itadinanta/cnc_mill_prototype/atx_board.FCStd

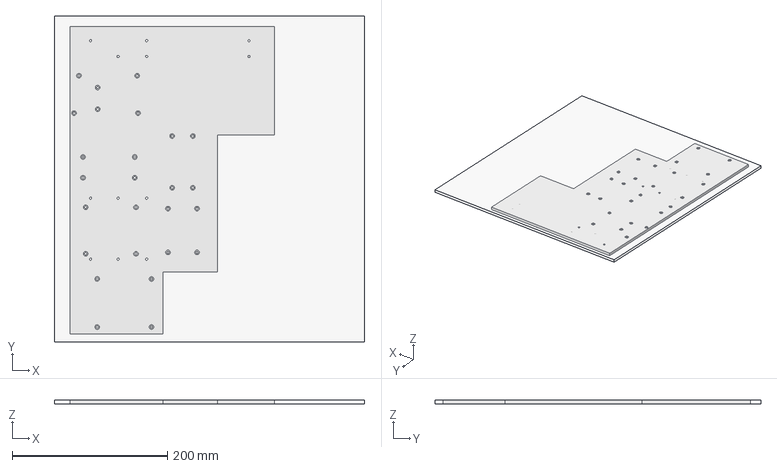
[picture p1: CAD file, 2020-03-13]
atx_board.FCStd
400.0 x 420.0 x 5.00 mm
Back_Face
Stock001
