itadinanta/cnc_mill_prototype/bed/bed.FCStd

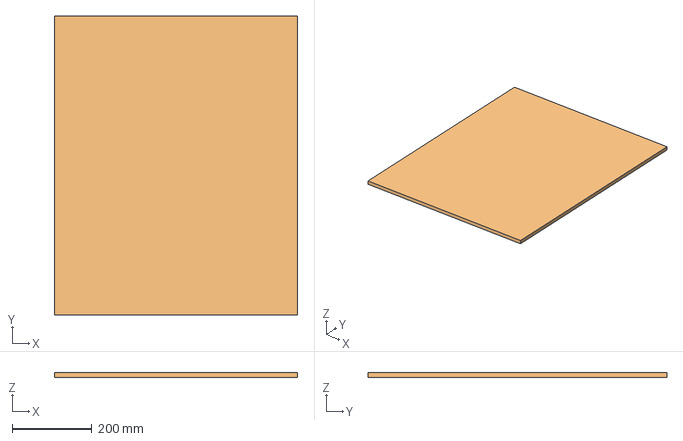
[picture p2: CAD file, 2020-03-01]
bed/bed.FCStd
610.0 x 750.0 x 12.0 mm
Stock
Stock001
