itadinanta/cnc_mill_prototype/test/calibration.FCStd

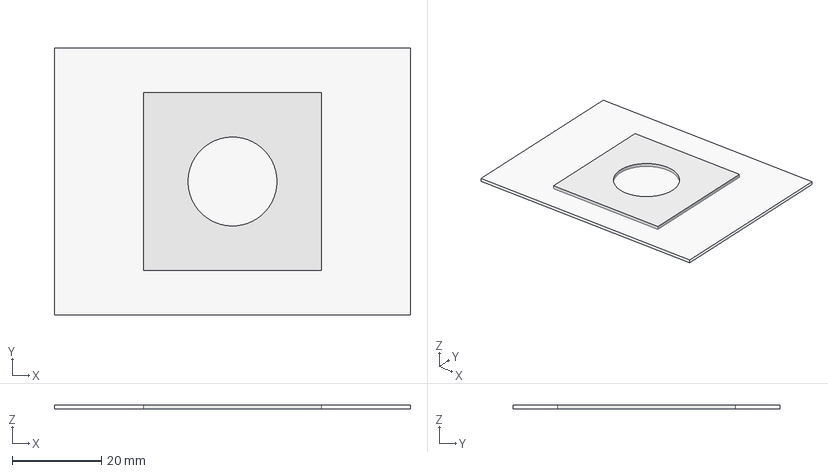
[picture p3: CAD file, 2019-11-09]
test/calibration.FCStd
80.0 x 60.0 x 1.00 mm
Model-Part
Stock
