itadinanta/cnc_mill_prototype/workbench/workbench.FCStd

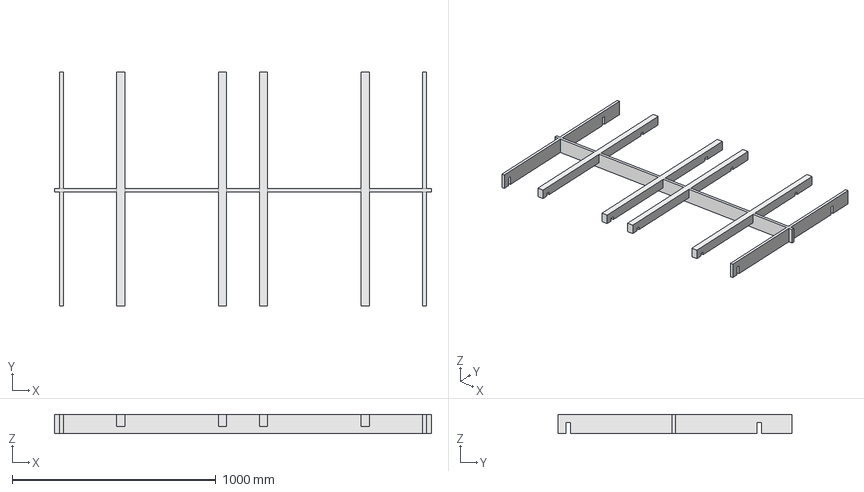
[picture p4: CAD file, 2019-11-04]
workbench/workbench.FCStd
1850.0 x 1150.0 x 95.0 mm
