itadinanta/cnc_mill_prototype/touch_plate.FCStd

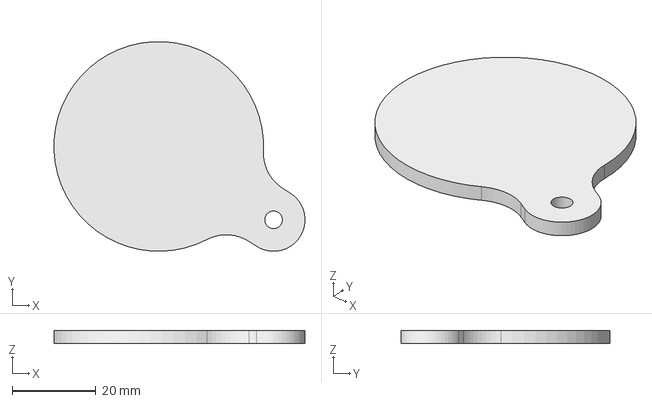
[picture p5: CAD file, 2020-02-16]
touch_plate.FCStd
59.9 x 50.0 x 3.00 mm
