itadinanta/cnc_mill_prototype/workbench/box.FCStd

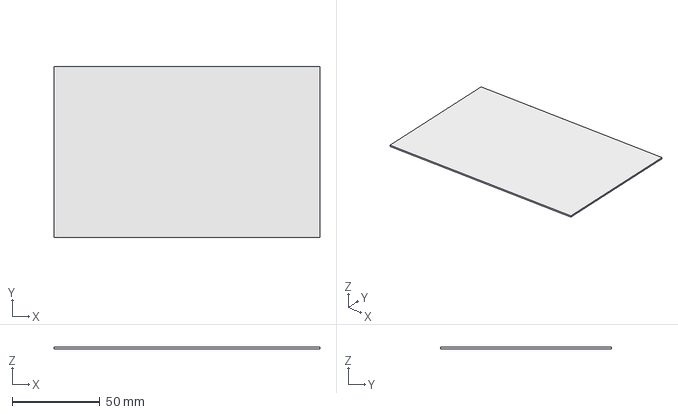
[picture p6: CAD file, 2019-11-03]
workbench/box.FCStd
152.0 x 98.0 x 1.00 mm
