itadinanta/cnc_mill_prototype/inverter_holder.FCStd

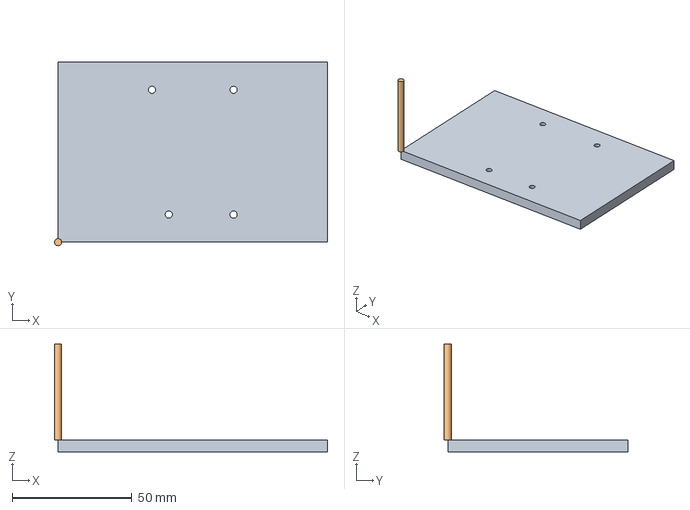
[picture p7: CAD file, 2019-12-30]
inverter_holder.FCStd
113.8 x 76.5 x 45.0 mm
tool
