itadinanta/cnc_mill_prototype/spindle_bracket_adapter.FCStd

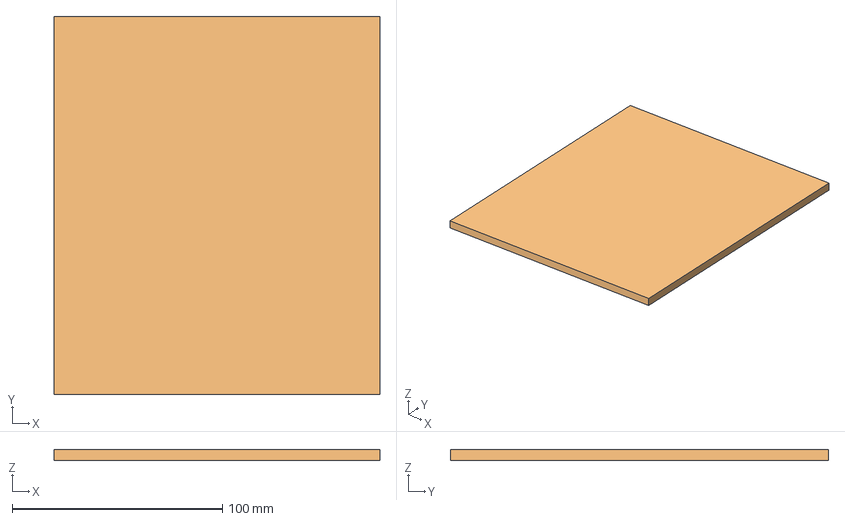
[picture p8: CAD file, 2019-12-23]
spindle_bracket_adapter.FCStd
155.0 x 180.0 x 5.00 mm
Stock
Stock001
