itadinanta/cnc_mill_prototype/cnc_mill_prototype.FCStd

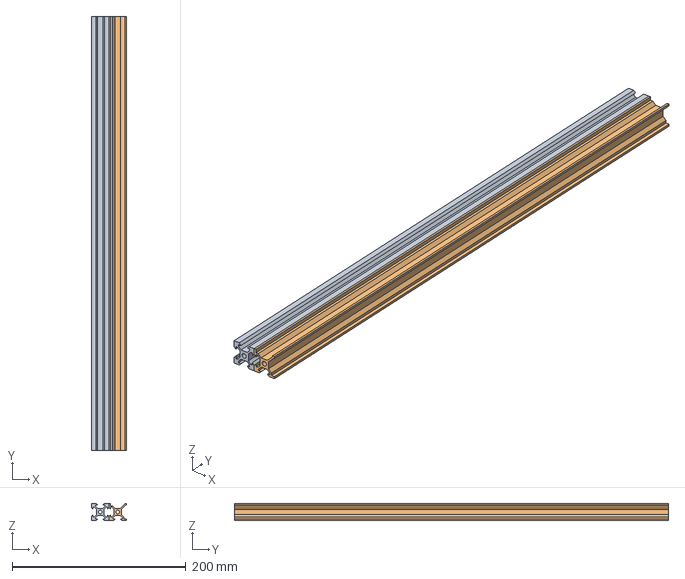
[picture p9: CAD file, 2019-07-23]
cnc_mill_prototype.FCStd
40.0 x 500.0 x 20.0 mm
