itadinanta/cnc_mill_prototype/(list of files, drawings)

Other design files:
arduino_duo_shield/arduino_duo_shield.dsn
