itadinanta/cnc_mill_prototype/arduino_duo_shield/arduino_duo_shield.kicad_pcb

## KiCad design arduino_duo_shield/arduino_duo_shield.kicad_pcb (2020-02-06)

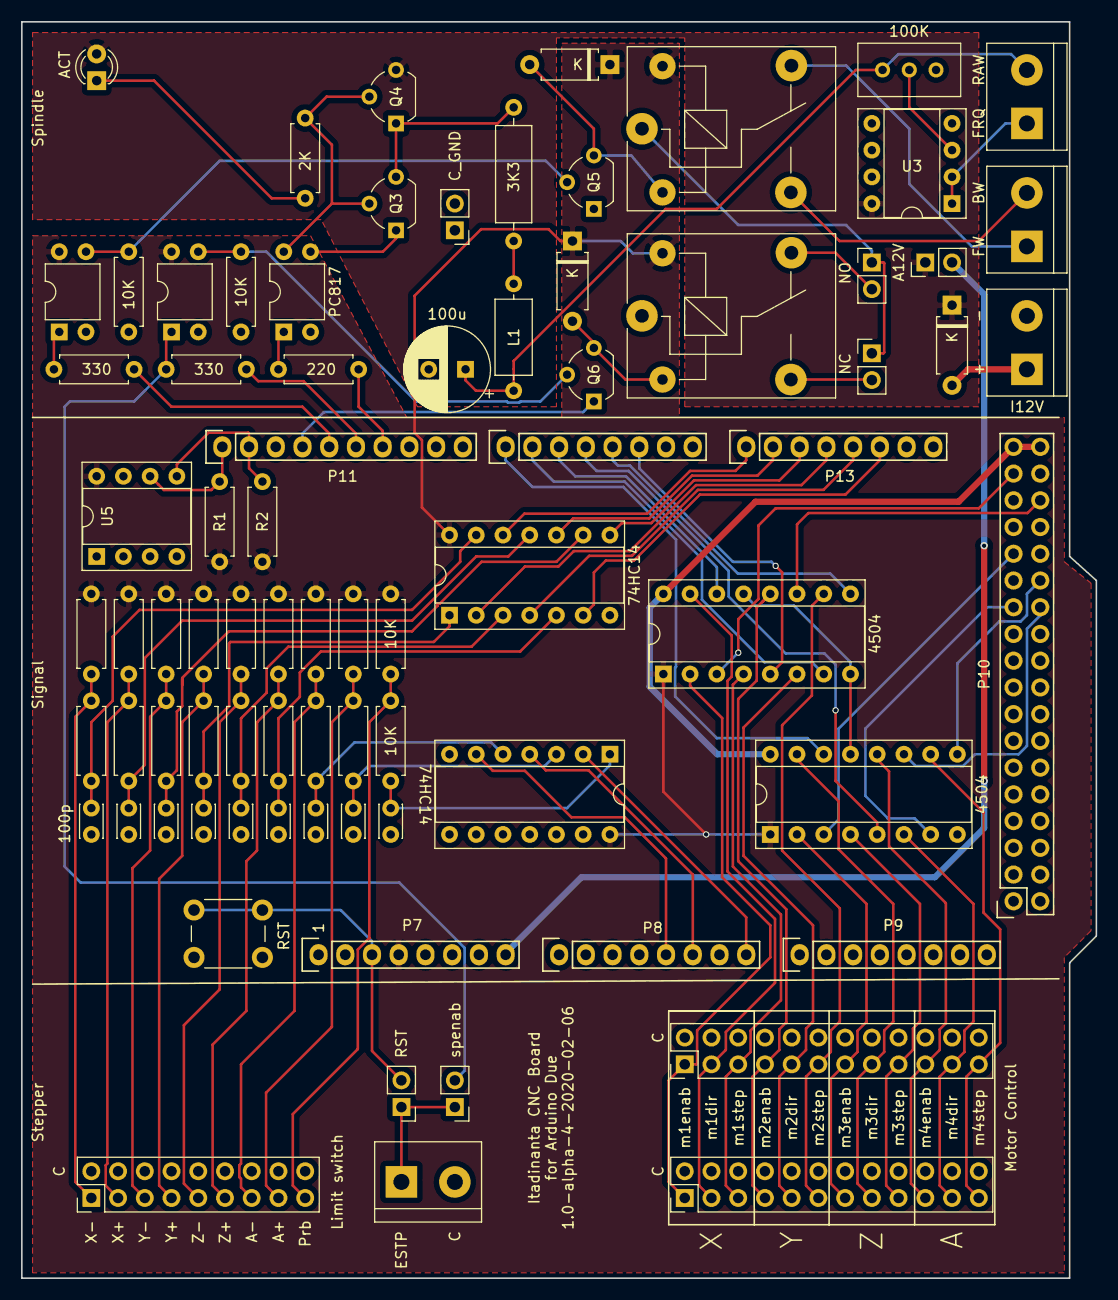
[picture p10: board arduino_duo_shield.kicad_pcb from above]

Board: 2 copper layers, 102.1 x 119.4 mm, 79 parts (0 on the bottom side), 84 nets.

Parts:
C2, C3, C4, C5, C6, C7, C9, C10, C11: 100p; C_Disc_D3.0mm_W2.0mm_P2.50mm
C8: 100u; CP_Radial_D8.0mm_P3.50mm
D1: LED; LED_D3.0mm
D3, D4, D5: 1N4007; D_A-405_P7.62mm_Horizontal
J2: EStop; TerminalBlock_bornier-2_P5.08mm
J3: Motor_Control; PinHeader_2x12_P2.54mm_Vertical
J4: Limit_Switches; PinHeader_2x09_P2.54mm_Vertical
J5: inverter_freq; TerminalBlock_bornier-2_P5.08mm
J6: inverter_cmd; TerminalBlock_bornier-2_P5.08mm
J8: inverter_power; TerminalBlock_bornier-2_P5.08mm
J9: Motor_Control_Mirror; PinHeader_2x12_P2.54mm_Vertical
JP1, JP2, JP3, JP4: Jumper_NC_Small; PinHeader_1x02_P2.54mm_Vertical
JP5: EStop_RST; PinHeader_1x02_P2.54mm_Vertical
JP6: EStop_spenab; PinHeader_1x02_P2.54mm_Vertical
K2, K3: JQC-3F; Relay_SPDT_SANYOU_SRD_Series_Form_C
L1: 1m; L_Axial_L7.0mm_D3.3mm_P10.16mm_Horizontal_Fastron_MICC
P7: Power; Socket_Strip_Arduino_1x08
P8, P9: Analog; Socket_Strip_Arduino_1x08
P10: Digital; Socket_Strip_Arduino_2x18
P11: PWM; Socket_Strip_Arduino_1x10
P12: PWM; Socket_Strip_Arduino_1x08
P13: Communication; Socket_Strip_Arduino_1x08
Q3, Q5, Q6: 2N7000; TO-92_Wide
Q4: BS250; TO-92_Wide
R1, R2: 1K5; R_Axial_DIN0207_L6.3mm_D2.5mm_P7.62mm_Horizontal
R3, R4, R5, R6, R7, R8, R9, R10, R11, R12, R13, R14, R19, R20, R25, R26, R27, R28, R29, R30: 10K; R_Axial_DIN0207_L6.3mm_D2.5mm_P7.62mm_Horizontal
R15: 220; R_Axial_DIN0207_L6.3mm_D2.5mm_P7.62mm_Horizontal
R21: 2K; R_Axial_DIN0207_L6.3mm_D2.5mm_P7.62mm_Horizontal
R22, R24: 330; R_Axial_DIN0207_L6.3mm_D2.5mm_P7.62mm_Horizontal
R23: 3K3; R_Axial_DIN0309_L9.0mm_D3.2mm_P12.70mm_Horizontal
RV1: 100K; Potentiometer_Bourns_3296W_Vertical
SW1: SW_Push; SW_PUSH_6mm
U1, U2: 4504; DIP-16_W7.62mm_Socket
U3: LM358; DIP-8_W7.62mm_Socket
U4, U6: 74HC14; DIP-14_W7.62mm_Socket
U5: 24LC16; DIP-8_W7.62mm_Socket
U7, U8, U9: PC817; DIP-4_W7.62mm

Connections:
+3V3: D3.1, D4.1, K2.5, K3.5, P7.4, R1.2, R2.1, R3.2, R5.2, R7.2, R9.2, R11.2, R13.2, R19.2, R27.2, R29.2, U1.1, U2.1, U4.14, U5.8, U6.14, U8.4, U9.4
+5V: P10.35, P10.36, U1.16, U2.16
/Debounce_x6/SWAmax+: J4.15, R27.1, R28.2
/Debounce_x6/SWAmin+: J4.13, R29.1, R30.2
/Debounce_x6/SWProbe+: J4.17, R19.1, R20.2
/Debounce_x6/SWXmax+: J4.3, R11.1, R12.2
/Debounce_x6/SWXmin+: J4.1, R13.1, R14.2
/Debounce_x6/SWYmax+: J4.7, R7.1, R8.2
/Debounce_x6/SWYmin+: J4.5, R9.1, R10.2
/Debounce_x6/SWZmax+: J4.11, R3.1, R4.2
/Debounce_x6/SWZmin+: J4.9, R5.1, R6.2
/Level_Shifter/hi_1_1: J3.1, J9.1, U1.2
/Level_Shifter/hi_1_2: J3.3, J9.3, U1.15
/Level_Shifter/hi_1_3: J3.5, J9.5, U1.4
/Level_Shifter/hi_1_4: J3.7, J9.7, U1.12
/Level_Shifter/hi_1_5: J3.9, J9.9, U1.6
/Level_Shifter/hi_1_6: J3.11, J9.11, U1.10
/Level_Shifter/hi_2_1: J3.13, J9.13, U2.2
/Level_Shifter/hi_2_2: J3.15, J9.15, U2.15
/Level_Shifter/hi_2_3: J3.17, J9.17, U2.4
/Level_Shifter/hi_2_4: J3.19, J9.19, U2.12
/Level_Shifter/hi_2_5: J3.21, J9.21, U2.6
/Level_Shifter/hi_2_6: J3.23, J9.23, U2.10
/Reset: JP5.2, P7.3, SW1.2
/SCL: P11.1, R1.1, U5.6
/SDA: P11.2, R2.2, U5.5
/Spindle_VFD_Control/I_PWRSAFE: D1.2, D5.1, JP4.1, Q4.3, U3.8
/Spindle_VFD_Control/ext_estop: JP6.2, R24.2, U9.1
/Spindle_VFD_Control/inverter_12V: D5.2, J8.1
/Spindle_VFD_Control/inverter_bw_switch: J6.2, K3.3
/Spindle_VFD_Control/inverter_frequency_10V: J5.1, U3.1, U3.2
/Spindle_VFD_Control/inverter_frequency_raw_10V: C8.1, J5.2, L1.2, RV1.1
/Spindle_VFD_Control/inverter_fw_switch: J6.1, K3.4
/Spindle_VFD_Control/inverter_gnd: C8.2, J8.2, JP1.1, K2.1, Q3.1, RV1.3, U3.4, U7.3
Amn: P8.5, U6.6
Amx: P8.6, U6.4
GND: C2.1, C3.1, C4.1, C5.1, C6.1, C7.1, C9.1, C10.1, C11.1, J2.2, J3.2, J3.4, J3.6, J3.8, J3.10, J3.12, J3.14, J3.16, J3.18, J3.20, J3.22, J3.24, J4.2, J4.4, J4.6, J4.8, J4.10, J4.12, J4.14, J4.16, J4.18, J9.2, J9.4, J9.6, J9.8, J9.10, J9.12, J9.14, J9.16, J9.18, J9.20, J9.22, J9.24, JP1.2, P7.6, P7.7, P10.1, P10.2, P11.4, Q5.1, Q6.1, R25.2, R26.2, SW1.1, U1.8, U1.13, U2.8, U2.13, U4.7, U5.4, U5.7, U6.7, U7.2, U8.2, U9.2
unnamed: C2.2, R4.1, U4.5
unnamed: C3.2, R6.1, U4.3
unnamed: C4.2, R8.1, U4.1
unnamed: C5.2, R10.1, U4.9
unnamed: C6.2, R12.1, U4.11
unnamed: C7.2, R14.1, U4.13
unnamed: C9.2, R20.1, U6.1
unnamed: C10.2, R28.1, U6.3
unnamed: C11.2, R30.1, U6.5
unnamed: D1.1, R21.1
unnamed: D3.2, K3.2, Q5.3
unnamed: D4.2, K2.2, Q6.3
unnamed: J2.1, JP5.1, JP6.1
unnamed: JP2.1, JP3.1, K3.1
unnamed: JP2.2, K2.3
unnamed: JP3.2, K2.4
unnamed: L1.1, R23.2
unnamed: Q3.2, Q4.2, R21.2, U7.4
unnamed: Q3.3, Q4.1, R23.1
unnamed: Q5.2, R25.1, U8.3
unnamed: Q6.2, R26.1, U9.3
unnamed: R15.2, U7.1
unnamed: R22.2, U8.1
unnamed: RV1.2, U3.3
Probe: P8.8, U6.2
Xmn: P13.1, U4.12
Xmx: P13.2, U4.10
Ymn: P13.3, U4.8
Ymx: P13.4, U4.2
Zmn: P13.5, U4.4
Zmx: P13.6, U4.6
ext_12v: JP4.2, P7.8
m1dir: P12.3, U1.14
m1enab: P10.33, U1.3
m1step: P12.6, U1.5
m2dir: P12.2, U1.7
m2enab: P10.32, U1.11
m2step: P12.5, U1.9
m3dir: P12.1, U2.14
m3enab: P10.27, U2.3
m3step: P12.4, U2.5
m4dir: P10.23, U2.7
m4enab: P10.24, U2.11
m4step: P10.26, U2.9
spdir: P11.5, R22.1
spenab: P11.6, R24.1
sppwm: P11.7, R15.1
