itadinanta/cnc_mill_prototype/(threads)

Thread 1 (2020-01-24):

Screw connectors

coredump, 2020-01-24:
Hello! I saw your comment on the GRBL HAL discussion and promptly decided to make some of your shields.

I have a question and a request tho:

1) How does the Schmitt trigger compare to the GRBL wiki solution using opto-couplers?
2) I changed the PCB to use screw connectors instead of pin headers, would love if you could take a look at my branch (https://github.com/coredump/cnc_mill_prototype/tree/coredump_screw_connectors) to see if I am not forgetting/doing something stupid before sending it to JLPCB 😄

Thanks, the shield looks awesome and I am excited to use it.

norru, 2020-02-03:
Oh, cool!

1. I haven't tried the optocoupler solution but the Schmitt debouncers work flawlessly for me. I've been recommended to try the optocoupler solution too, will probably give it a shot in the future.

2. Alright, I'll try and see if I can have a peek this week!

> Thanks, the shield looks awesome and I am excited to use it.

Oh, dear, what courage! :D Good luck with that, bear in mind this is a work in progress, but very happy to be of help!

norru, 2020-02-05:
@coredump I've added external EEPROM to my board schematic. It's a simple addition that you may want to sync over.

I'll probably tidy up a little bit then send it out for etching. If you wait a bit I'll get this tested first so you don't have to play blind :)

coredump, 2020-02-06:
That's interesting. How would you use the EEPROM? Does any of the firmwares support it out of the box?

norru, 2020-02-06:
Yes, it's been recommended by @terjejo as I'm using his branch of GRBL https://github.com/terjeio/grblHAL (with small tweaks on top).

coredump, 2020-02-07:
Hello again. I surely hope your stuff is open source, because I got a log of ideas from you to make this 😄

https://cadlab.io/project/2459/1f6db917/files

My plan is to make a 'generic' daughter card that can be used with differnt MCUs/firmwares. So what I basically did was to shove everything I need to run with external drivers/VFDs/opto isolated switches and 3.3v logic on a single board. I kinda copied the connector design from MESA cards too.

I still testing those circuits on a breadboard, and I think  my PWM-10V converter is a little too complicated/maybe unsafe, but I will probably make some of those prototype boards and test it.

I am also creating smaller shields for ESP32, Arduino Due and a connector for TIVA-C boards that I will use to test GRBLHAL and g2core.

I would appreciate any tips/reviews/ideas, and again sorry because there are some stuff on my work that is clearly almost the same as yours (there are only so many ways I can put an eeprom chip) but if it bothers you lmk and I will change it.

norru, 2020-02-08:
Hi José,

sure, all the public stuff I've got on GitHub is open source and it's an
original design.

Perhaps I should make it clear and upload a Creative Commons disclaimer,the
idea is to go for https://creativecommons.org/licenses/by-sa/4.0/ or even
https://creativecommons.org/licenses/by/4.0/.

I have no plans to distribute or sell my boards as finished products, all I
need is a bespoke design which works for me, but I am super happy to share
and compare notes on anything interesting.

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

--
Cheers,
Nico

coredump, 2020-02-08:
As a GPL person, I will probably use this
https://creativecommons.org/share-your-work/licensing-examples/#by-nc-sa or
research some OHW license.

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

norru, 2020-02-08:
I am ok for people to use these projects in a commercial context as long as
I am credited, at least for now.

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
