itadinanta/cnc_mill_prototype/(commit log)

2019-07-20 Added holes as pockets
    [cnc_mill_prototype.FCStd]
2019-07-21 Basic C-Beam profile
    [cnc_mill_prototype.FCStd]
2019-07-21 Adds corner side by side
    [cnc_mill_prototype.FCStd]
2019-07-23 Last V-slot sketch
    [cnc_mill_prototype.FCStd]
2019-08-21 Add debounce x6 for limit switches
    [Debounce_x6.sch, arduino_duo_shield.kicad_pcb, arduino_duo_shield.sch]
2019-08-31 Add labels and footprints
    [Debounce_x6.sch, arduino_duo_shield.kicad_pcb, arduino_duo_shield.sch]
2019-09-01 Replace 4x 6x connectors with 1x 24x, add firmware
    [Debounce_x6.sch, arduino_duo_shield.kicad_pcb, arduino_duo_shield.sch]
2019-09-02 Add firmware to fix the power-on bug
2019-09-06 Fixed power pins
    [arduino_duo_shield.sch]
2019-09-11 Use only 1 VPOW in spindle control
    [Debounce_x6.sch, Spindle_Power_Control.sch, arduino_duo_shield.kicad_pcb, arduino_duo_shield.sch]
2019-09-12 Power block to PCB
    [Spindle_Power_Control.sch, arduino_duo_shield.kicad_pcb, arduino_duo_shield.sch]
2019-09-14 Add PCB front/back for spindle controls
    [Spindle_Power_Control.sch, arduino_duo_shield.kicad_pcb, arduino_duo_shield.sch]
2019-09-21 Complete wiring
    [Debounce_x6.sch, Level_Shifter.sch, Spindle_Power_Control.sch, arduino_duo_shield.kicad_pcb, arduino_duo_shield.sch]
2019-09-22 Plot layouts to upload to to JLBPCB
    [arduino_duo_shield-B_CrtYd.gbr, arduino_duo_shield-B_Cu.gbr, arduino_duo_shield-B_Mask.gbr, arduino_duo_shield-B_SilkS.gbr, arduino_duo_shield-Dwgs_User.gbr, arduino_duo_shield-Edge_Cuts.gbr, arduino_duo_shield-F_CrtYd.gbr, arduino_duo_shield-F_Cu.gbr]
2019-10-07 Add ketch for box container
    [box.FCStd]
2019-10-12 Fix diode symbol in schematic
    [Spindle_Power_Control.sch, arduino_duo_shield.dsn, arduino_duo_shield.kicad_pcb]
2019-11-03 Add physical workbench diagrams
    [box.FCStd, workbench.FCStd]
2019-11-04 Complete workbench frame sketches
    [workbench.FCStd]
2019-11-04 CAD plans
    [workbench.FCStd]
2019-11-09 Test cuts (mostly flattening)
    [calibration.FCStd]
2019-11-20 Prototype filter-based PWM->voltage DAC
    [Debounce_x6.sch, Level_Shifter.sch, RLC.kicad_pcb, RLC.sch, Spindle_Power_Control.sch, Spindle_VFD_Control.sch, arduino_duo_shield.sch]
2019-11-25 Add sketch for the spindle bracket adapter
    [spindle_bracket_adapter.FCStd]
2019-12-04 Recalculate paths of spindle adapter
    [Spindle_VFD_Control.sch, spindle_bracket_adapter.FCStd]
2019-12-23 Ready to build the WorkBee
    [spindle_bracket_adapter.FCStd]
2019-12-23 Add signal mirror and control jumpers
    [Debounce_x6.sch, Level_Shifter.sch, Spindle_Power_Control.sch, Spindle_VFD_Control.sch, arduino_duo_shield.sch]
2019-12-27 Add design and paths for simple inverter holding panel
    [inverter_holder.FCStd]
2019-12-29 Route all paths
    [Debounce_x6.sch, Level_Shifter.sch, Spindle_VFD_Control.sch, arduino_duo_shield.kicad_pcb, arduino_duo_shield.sch]
2019-12-29 Add silk screen labels and version number
    [Spindle_VFD_Control.sch, arduino_duo_shield.kicad_pcb]
2019-12-30 Generate gerber files for 1.0-alpha-1
    [Spindle_VFD_Control.sch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]
2020-01-08 Add flatten operation
    [bed.FCStd]
2020-01-08 Add voltage follower as end stage of spindle control
    [Spindle_VFD_Control.sch, arduino_duo_shield.kicad_pcb, arduino_duo_shield.sch]
2020-01-12 Expose raw analog frequency control
    [Spindle_VFD_Control.sch, arduino_duo_shield.kicad_pcb, arduino_duo_shield.sch]
2020-01-14 Add support for spindle estop
    [Spindle_VFD_Control.sch, arduino_duo_shield.kicad_pcb, arduino_duo_shield.sch]
2020-01-14 Adjust labels
    [arduino_duo_shield.kicad_pcb]
2020-02-03 Add support for 24LC16 EEPROM
    [arduino_duo_shield-B_CrtYd.gbr, arduino_duo_shield-B_Cu.gbr, arduino_duo_shield-B_Mask.gbr, arduino_duo_shield-B_SilkS.gbr, arduino_duo_shield-Dwgs_User.gbr, arduino_duo_shield-Edge_Cuts.gbr, arduino_duo_shield-F_CrtYd.gbr, arduino_duo_shield-F_Cu.gbr]
2020-02-06 Tidy up, generate plots for JLCPCB, alpha 4
    [arduino_duo_shield-B_CrtYd.gbr, arduino_duo_shield-B_Cu.gbr, arduino_duo_shield-B_Mask.gbr, arduino_duo_shield-B_SilkS.gbr, arduino_duo_shield-Dwgs_User.gbr, arduino_duo_shield-Edge_Cuts.gbr, arduino_duo_shield-F_CrtYd.gbr, arduino_duo_shield-F_Cu.gbr]
2020-02-16 Edit touch plate, redo holes in bed
    [bed.FCStd, touch_plate.FCStd]
2020-02-17 Generate helix cuts (Example)
    [bed.FCStd]
2020-02-19 Split edge from body holes and bores
    [bed.FCStd]
2020-02-22 Add flattening
    [bed.FCStd]
2020-02-23 Generate gcode for holes and bed flatten
    [bed.FCStd]
2020-03-01 Regenerate gcode for flatten with variant
    [bed.FCStd]
2020-03-03 Draw support board for ATX case
    [atx_board.FCStd]
2020-03-04 Add Arduino Due footprint
    [atx_board.FCStd]
2020-03-04 Add shield constraint
    [atx_board.FCStd]
2020-03-07 Add layout for larger booster
    [atx_board.FCStd]
2020-03-09 Add ammeter holder panel
    [atx_board.FCStd]
2020-03-09 Tweak view
    [atx_board.FCStd]
2020-03-10 Create counterbore om the back plane
    [atx_board.FCStd]
2020-03-13 Cut ATX board upgrade
    [atx_board.FCStd]
